h2lab/cw-leia-standalone-hard/(commit log)

2019-06-07 [enhancement] Add tests points for smartcard controlled triggers, connect PB4 to CARD_CLK for bitbanging mode
    [iface_ufo.sch, leia.kicad_pcb, leia.sch, smartcard.sch]
2019-06-12 [enhancement] WIP working on power domain isolation
    [iface_ufo.sch, leia.kicad_pcb, leia.sch]
2019-06-12 [enhancement] Add ground via for differential pairs
    [leia.kicad_pcb]
2019-06-13 [enhancement] Rework cw308 trigger con.
    [cpu.sch, iface_ufo.sch, leia.kicad_pcb, leia.sch]
2019-06-18 [enhancement] Rework Power plan.
    [cpu.sch, iface_ufo.sch, leia.kicad_pcb, leia.sch, smartcard.sch, usb.sch]
2019-06-19 [bugfix] Fix DRC on pcb
    [leia.kicad_pcb]
2019-06-19 [bugfix] Fix missing con. and moving some vias
    [leia.kicad_pcb]
2019-07-26 [enhancement] add HSE
    [cpu.sch, iface_ufo.sch, leia.kicad_pcb, leia.sch, smartcard.sch, usb.sch]
2019-07-26 [enhancement] add testpoint footprint
2019-11-18 [Fix] General cleanup before production
    [cpu.sch, iface_ufo.sch, leia.kicad_pcb, leia.sch]
2020-06-02 [fix] ground plans => ready for review
    [cpu.sch, iface_ufo.sch, leia.kicad_pcb, leia.sch, smartcard.sch, usb.sch]
2020-06-02 [update] switch to Cw 20 pin connector
    [iface_ufo.sch, leia.kicad_pcb, leia.sch, smartcard.sch, usb.sch]
