h2lab/cw-leia-standalone-hard/(notices)

Notices in the files:
usb.sch:
LICENCE: CERN Open Hardware Licence v1.2
